selfiebotrobot/SelfieBot/README.md

<b>What is it?</b>

 DIY SelfieBot is a Robot KIT for studying robotics. It allows you to enhance your skills in electronics design, programming, 3D printing, mechanics. You'll make your own robot for practical use! OS Android, face tracking, Arduino, servos...

1. Goto "1 BOM". Buy all necessary parts of robot.
2. Goto "2 Electronics design". Study electronics design.
3. Goto "3 Upload firmware". Upload firmware to the microcontroller. Try how it works.
4. etc.

You can find detailed instruction in the file "Full guidance How to make a DIY SelfieBot"
