selfiebotrobot/SelfieBot/(commit log)

2016-09-16 Add files via upload
    FULL GUIDANCE AND TUTORIAL: HOW TO MAKE A DIY SELFIEBOT.
    To buy BOM, to assemble, to upload firmware, to test robot.
2016-09-16 Firmware
    Program.ino is a firmware for Arduino Nano in the project.
